harris-newsteder/PL1/documentation/PL1-0_schematic.pdf

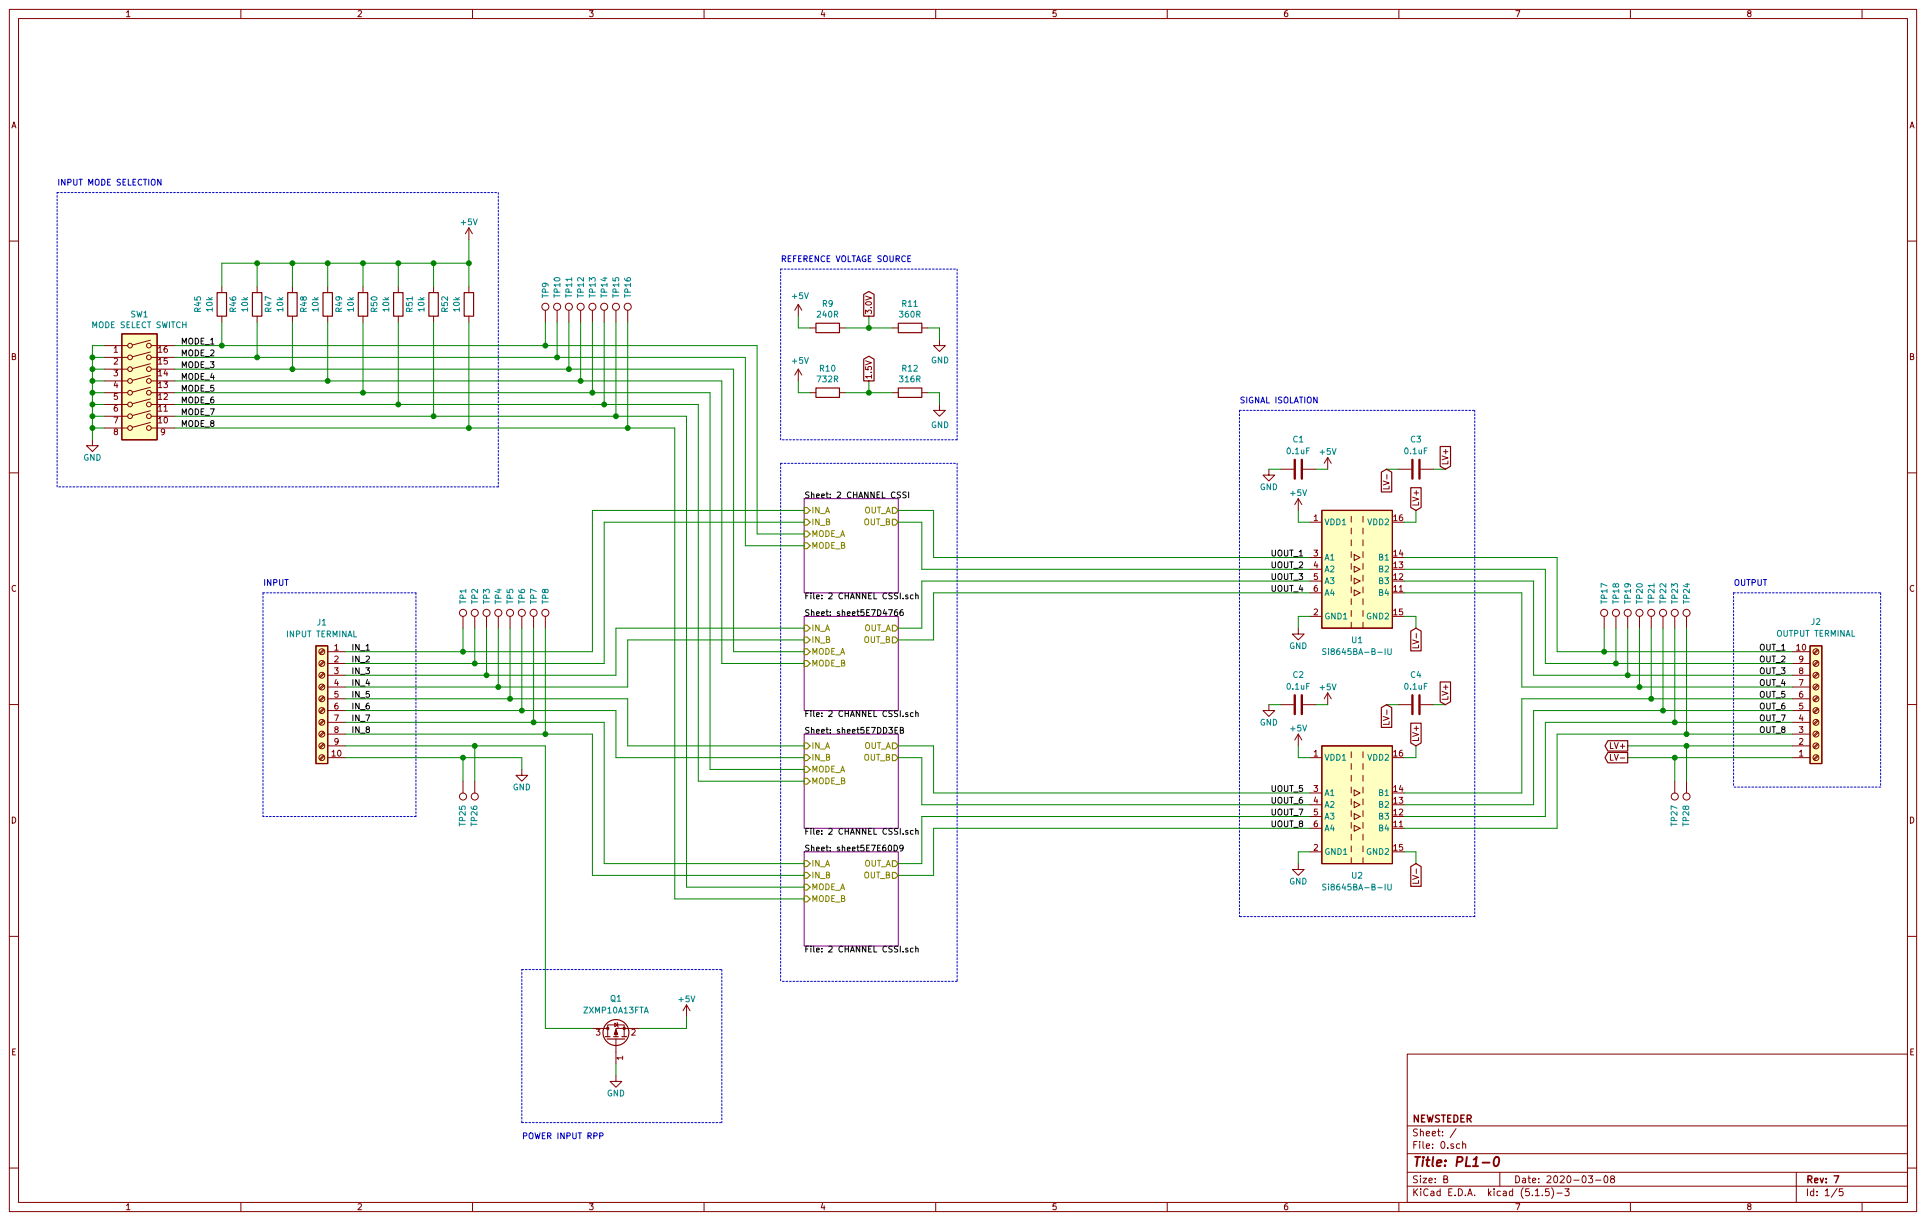
[picture p1: page 1]

Sheet: 2 CHANNEL CSSI File: 2 CHANNEL CSSI.sch

Sheet: sheet5E7D4766 File: 2 CHANNEL CSSI.sch

File: 2 CHANNEL CSSI.sch
Sheet: sheet5E7E60D9 File: 2 CHANNEL CSSI.sch

File: 0.sch Sheet: / NEWSTEDER

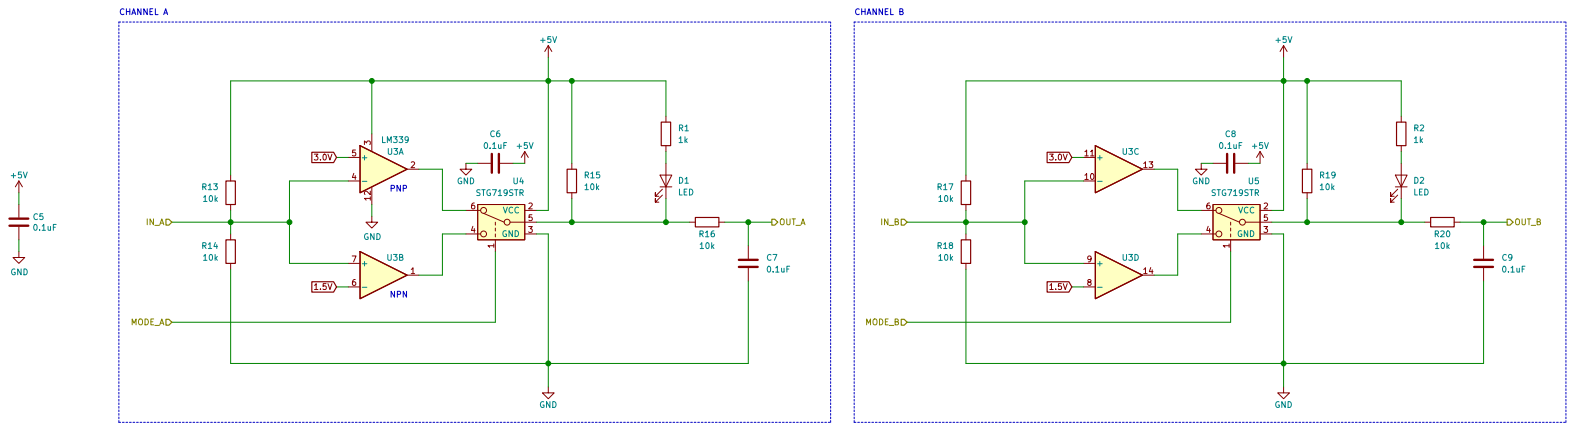
[picture p2: page 2]

File: 2 CHANNEL CSSI.sch Sheet: /2 CHANNEL CSSI/ NEWSTEDER

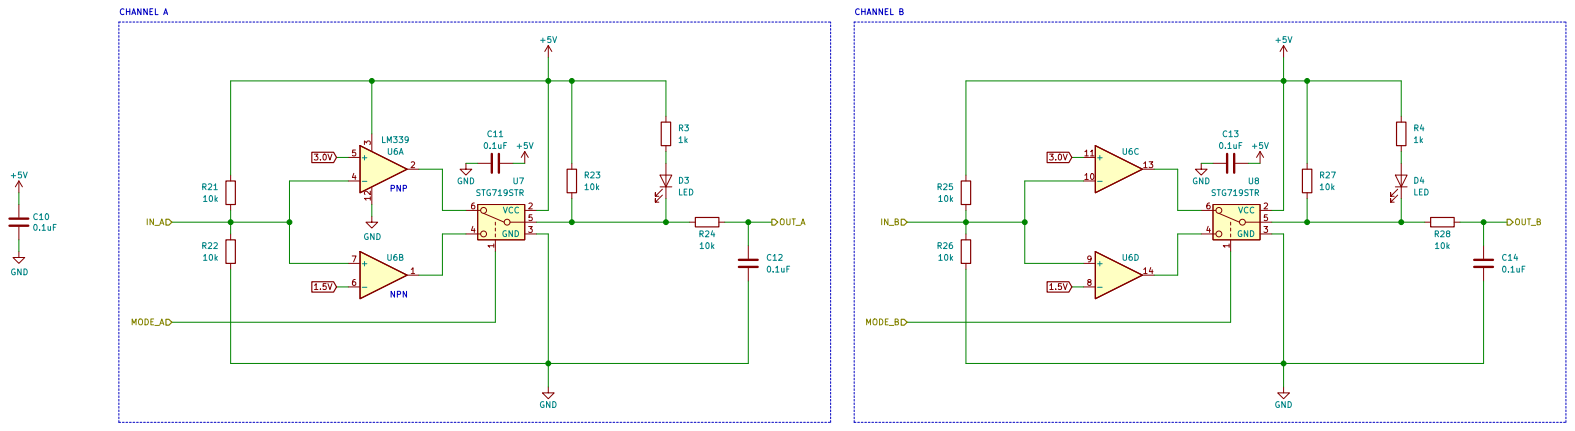
[picture p3: page 3]

File: 2 CHANNEL CSSI.sch Sheet: /sheet5E7D4766/ NEWSTEDER

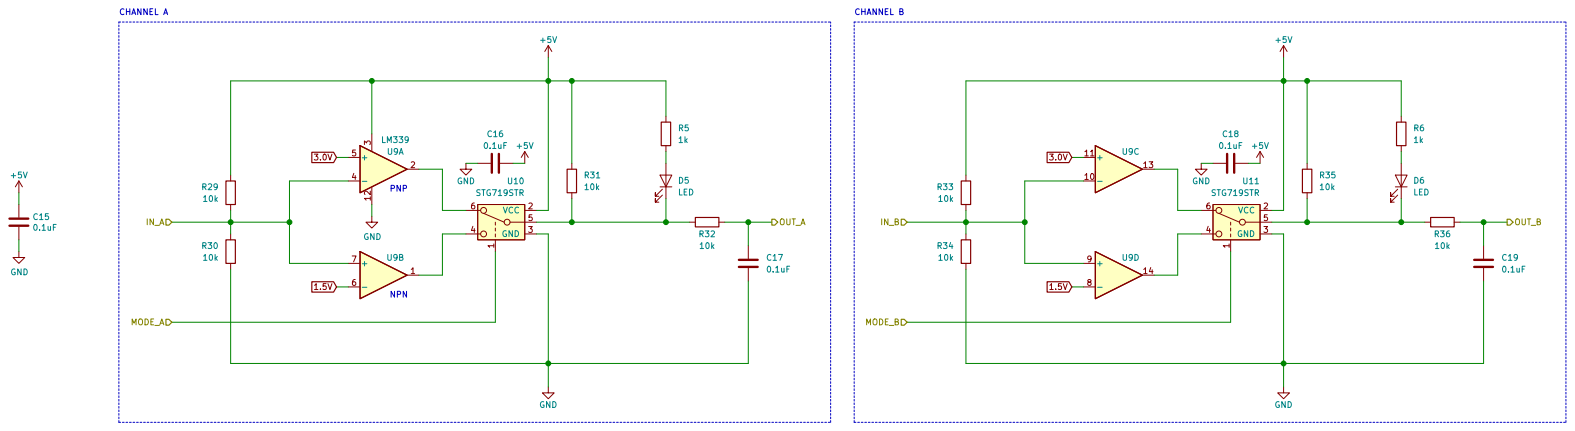
[picture p4: page 4]

File: 2 CHANNEL CSSI.sch Sheet: /sheet5E7DD3EB/ NEWSTEDER

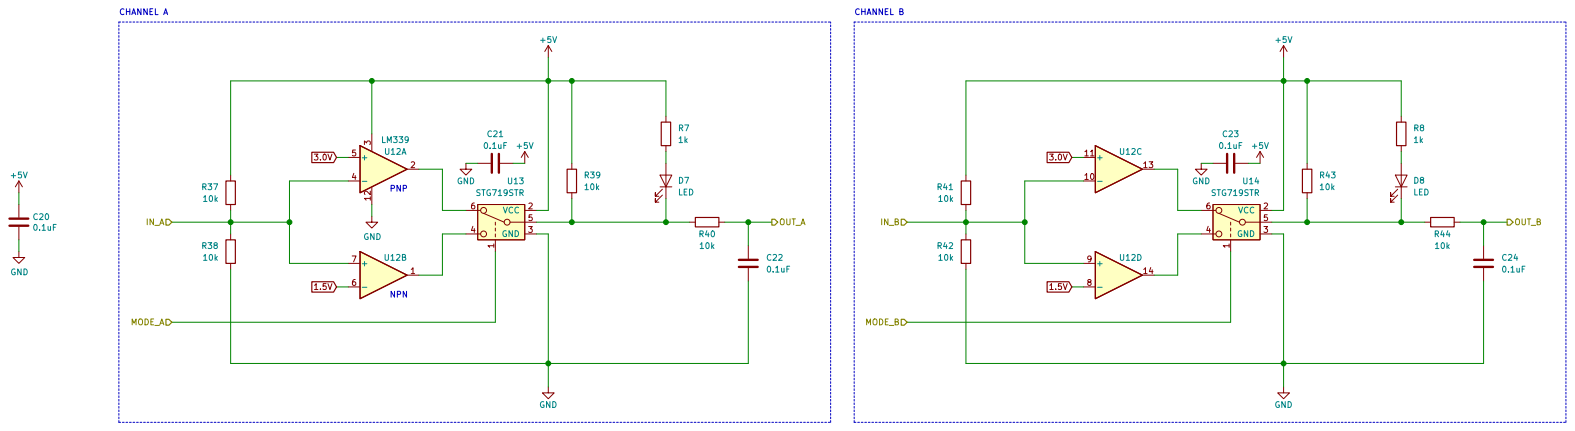
[picture p5: page 5]

File: 2 CHANNEL CSSI.sch Sheet: /sheet5E7E60D9/ NEWSTEDER
