harris-newsteder/PL1/documentation/PL1-0_dimensions.pdf

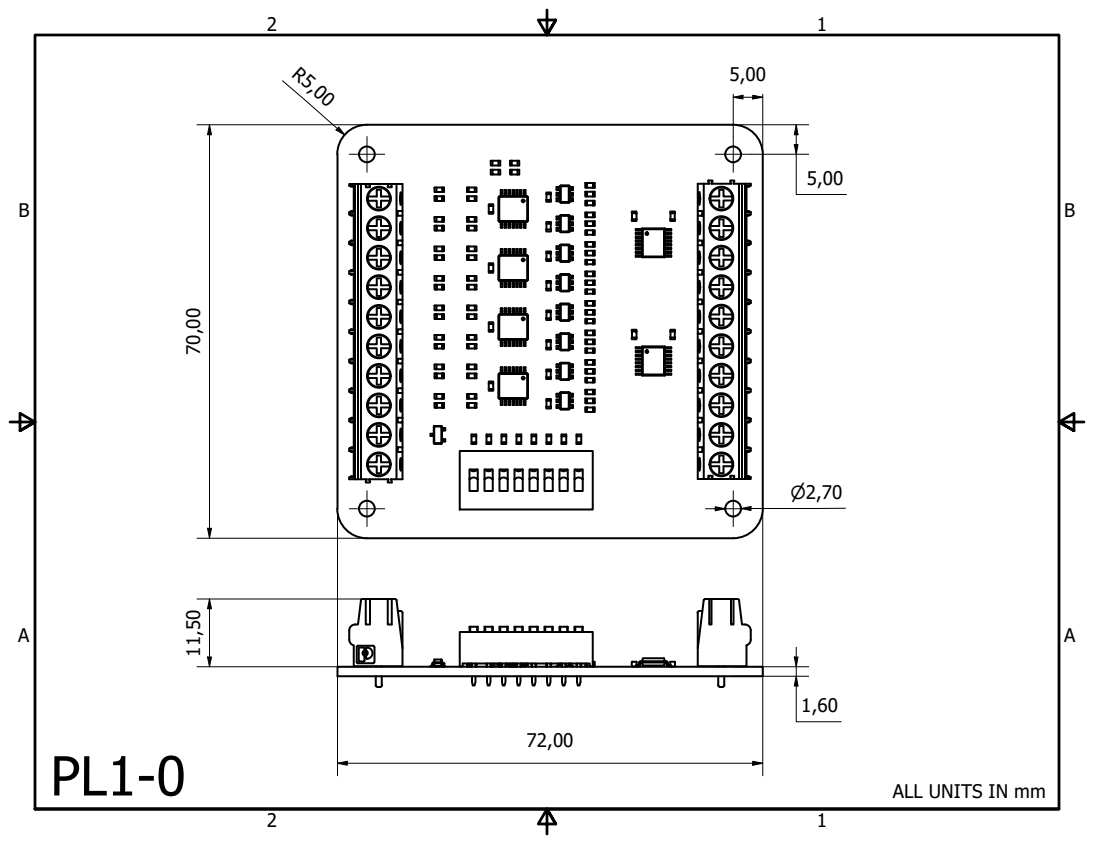
[picture p6: page 1]

ALL UNITS IN mm
