harris-newsteder/PL1/pcb/0/0.kicad_pcb

## KiCad design pcb/0/0.kicad_pcb (2020-06-17)

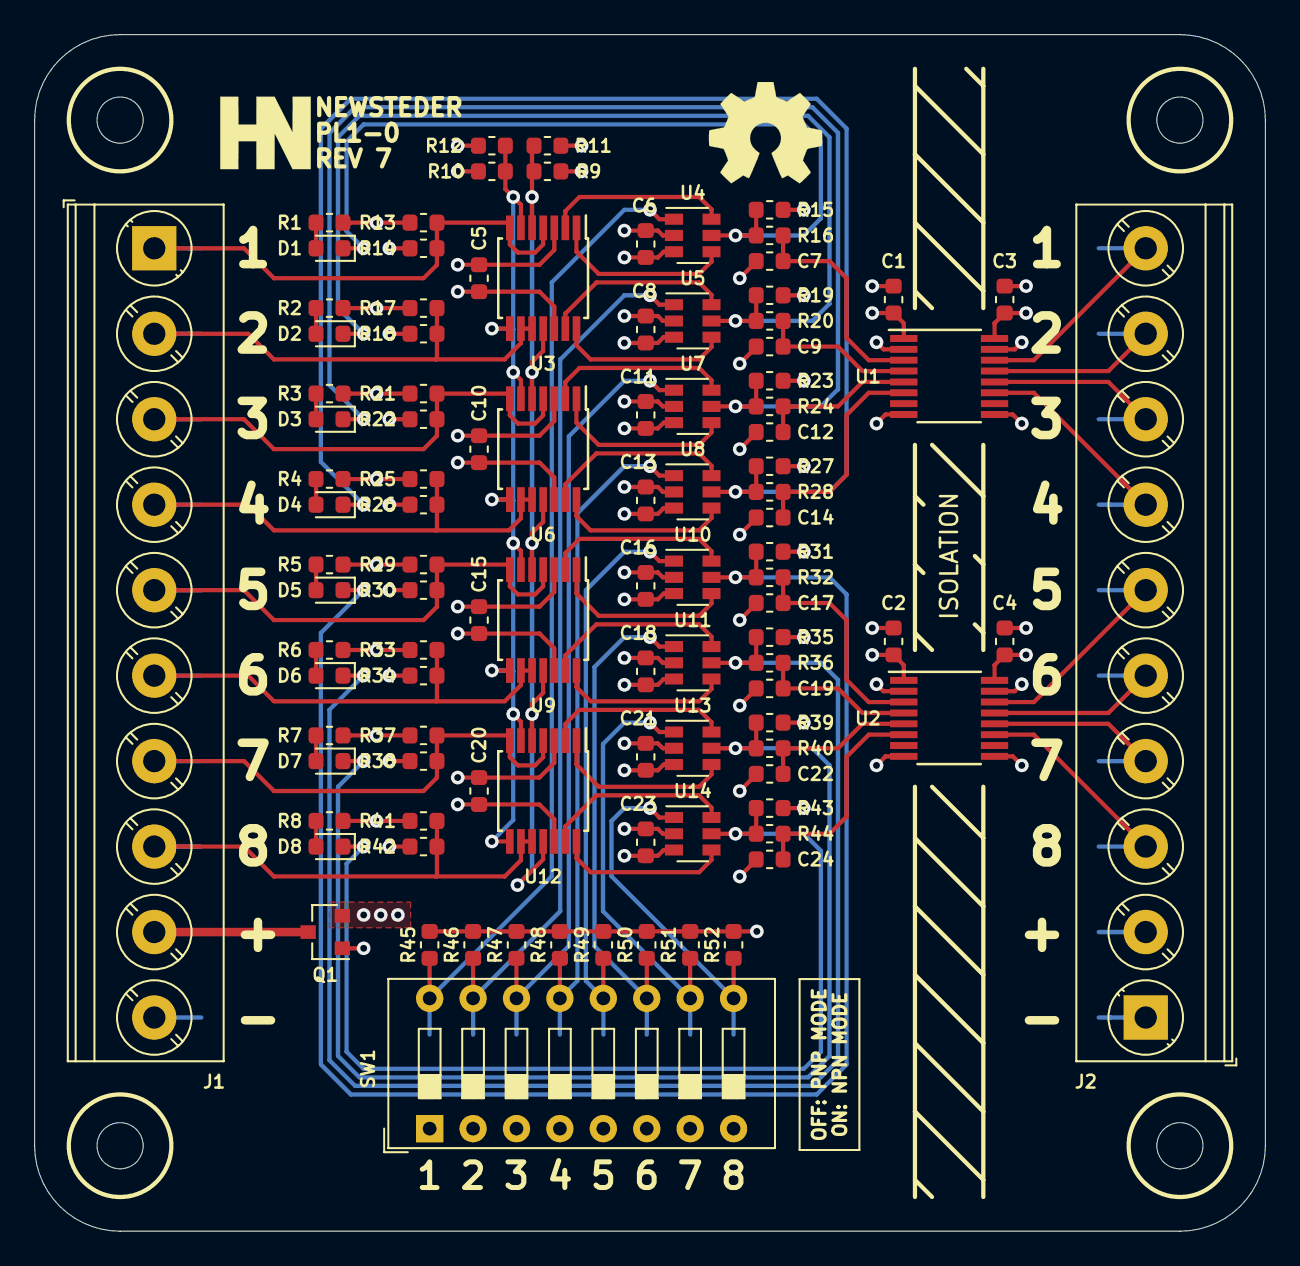
[picture p7: board 0.kicad_pcb from above]

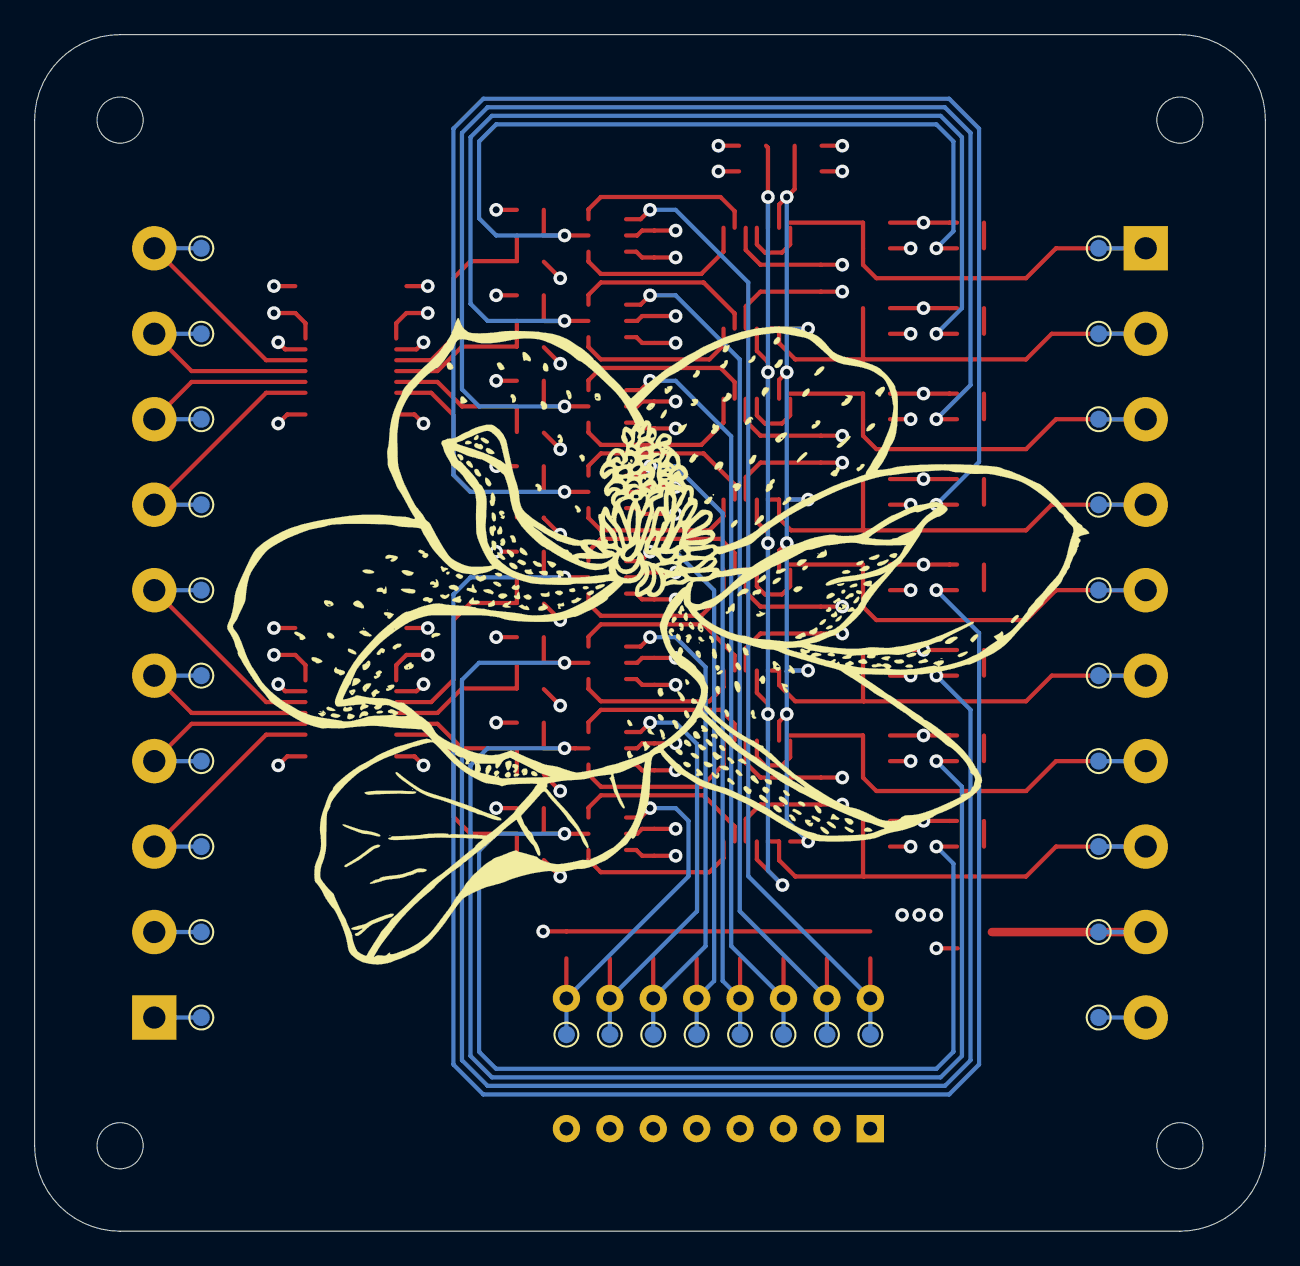
[picture p8: board 0.kicad_pcb from below]

Board: 4 copper layers, 72.0 x 70.0 mm, 130 parts (28 on the bottom side), 71 nets.

Parts:
C1, C2, C3, C4, C5, C6, C7, C8, C9, C10, C11, C12, C13, C14, C15, C16, C17, C18, C19, C20, C21, C22, C23, C24: 0.1uF; C_0603_1608Metric
D1, D2, D3, D4, D5, D6, D7, D8: LED; LED_0603_1608Metric
J1: INPUT TERMINAL; TerminalBlock_Phoenix_PT-1,5-10-5.0-H_1x10_P5.00mm_Horizont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
J2: OUTPUT TERMINAL; TerminalBlock_Phoenix_PT-1,5-10-5.0-H_1x10_P5.00mm_Horizont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
Q1: ZXMP10A13FTA; SOT-23
R1, R2, R3, R4, R5, R6, R7, R8: 1k; R_0603_1608Metric
R9: 240R; R_0603_1608Metric
R10: 732R; R_0603_1608Metric
R11: 360R; R_0603_1608Metric
R12: 316R; R_0603_1608Metric
R13, R14, R15, R16, R17, R18, R19, R20, R21, R22, R23, R24, R25, R26, R27, R28, R29, R30, R31, R32, R33, R34, R35, R36, R37, R38, R39, R40, R41, R42, R43, R44, R45, R46, R47, R48, R49, R50, R51, R52: 10k; R_0603_1608Metric
SW1: MODE SELECT SWITCH; SW_DIP_SPSTx08_Slide_9.78x22.5mm_W7.62mm_P2.54mm
TP1, TP2, TP3, TP4, TP5, TP6, TP7, TP8, TP9, TP10, TP11, TP12, TP13, TP14, TP15, TP16, TP17, TP18, TP19, TP20, TP21, TP22, TP23, TP24, TP25, TP26, TP27, TP28: TestPoint; TestPoint_Pad_D1.0mm
U1, U2: Si8645BA-B-IU; QSOP-16_3.9x4.9mm_P0.635mm
U3, U6, U9, U12: LM339; TSSOP-14_4.4x5mm_P0.65mm
U4, U5, U7, U8, U10, U11, U13, U14: STG719STR; SOT-23-6

Connections:
1.5V: R10.2, R12.1, U3.6, U3.8, U6.6, U6.8, U9.6, U9.8, U12.6, U12.8
3.0V: R9.2, R11.1, U3.5, U3.11, U6.5, U6.11, U9.5, U9.11, U12.5, U12.11
+5V: C1.2, C2.2, C5.1, C6.1, C8.1, C10.1, C11.1, C13.1, C15.1, C16.1, C18.1, C20.1, C21.1, C23.1, Q1.2, R1.1, R2.1, R3.1, R4.1, R5.1, R6.1, R7.1, R8.1, R9.1, R10.1, R13.1, R15.1, R17.1, R19.1, R21.1, R23.1, R25.1, R27.1, R29.1, R31.1, R33.1, R35.1, R37.1, R39.1, R41.1, R43.1, R45.1, R46.1, R47.1, R48.1, R49.1, R50.1, R51.1, R52.1, U1.1, U2.1, U3.3, U4.2, U5.2, U6.3, U7.2, U8.2, U9.3, U10.2, U11.2, U12.3, U13.2, U14.2
/IN_1: J1.1, R13.2, R14.1, TP1.1, U3.4, U3.7
/IN_2: J1.2, R17.2, R18.1, TP2.1, U3.9, U3.10
/IN_3: J1.3, R21.2, R22.1, TP3.1, U6.4, U6.7
/IN_4: J1.4, R25.2, R26.1, TP4.1, U6.9, U6.10
/IN_5: J1.5, R29.2, R30.1, TP5.1, U9.4, U9.7
/IN_6: J1.6, R33.2, R34.1, TP6.1, U9.9, U9.10
/IN_7: J1.7, R37.2, R38.1, TP7.1, U12.4, U12.7
/IN_8: J1.8, R41.2, R42.1, TP8.1, U12.9, U12.10
/MODE_1: R45.2, SW1.16, TP9.1, U4.1
/MODE_2: R46.2, SW1.15, TP10.1, U5.1
/MODE_3: R47.2, SW1.14, TP11.1, U7.1
/MODE_4: R48.2, SW1.13, TP12.1, U8.1
/MODE_5: R49.2, SW1.12, TP13.1, U10.1
/MODE_6: R50.2, SW1.11, TP14.1, U11.1
/MODE_7: R51.2, SW1.10, TP15.1, U13.1
/MODE_8: R52.2, SW1.9, TP16.1, U14.1
/OUT_1: J2.10, TP17.1, U1.14
/OUT_2: J2.9, TP18.1, U1.13
/OUT_3: J2.8, TP19.1, U1.12
/OUT_4: J2.7, TP20.1, U1.11
/OUT_5: J2.6, TP21.1, U2.14
/OUT_6: J2.5, TP22.1, U2.13
/OUT_7: J2.4, TP23.1, U2.12
/OUT_8: J2.3, TP24.1, U2.11
/UOUT_1: C7.1, R16.1, U1.3
/UOUT_2: C9.1, R20.1, U1.4
/UOUT_3: C12.1, R24.1, U1.5
/UOUT_4: C14.1, R28.1, U1.6
/UOUT_5: C17.1, R32.1, U2.3
/UOUT_6: C19.1, R36.1, U2.4
/UOUT_7: C22.1, R40.1, U2.5
/UOUT_8: C24.1, R44.1, U2.6
GND: C1.1, C2.1, C5.2, C6.2, C7.2, C8.2, C9.2, C10.2, C11.2, C12.2, C13.2, C14.2, C15.2, C16.2, C17.2, C18.2, C19.2, C20.2, C21.2, C22.2, C23.2, C24.2, J1.10, Q1.1, R11.2, R12.2, R14.2, R18.2, R22.2, R26.2, R30.2, R34.2, R38.2, R42.2, SW1.1, SW1.2, SW1.3, SW1.4, SW1.5, SW1.6, SW1.7, SW1.8, TP25.1, U1.2, U1.8, U2.2, U2.8, U3.12, U4.3, U5.3, U6.12, U7.3, U8.3, U9.12, U10.3, U11.3, U12.12, U13.3, U14.3
LV+: C3.2, C4.2, J2.2, TP28.1, U1.16, U2.16
LV-: C3.1, C4.1, J2.1, TP27.1, U1.9, U1.15, U2.9, U2.15
unnamed: D1.1, R15.2, R16.2, U4.5
unnamed: D1.2, R1.2
unnamed: D2.1, R19.2, R20.2, U5.5
unnamed: D2.2, R2.2
unnamed: D3.1, R23.2, R24.2, U7.5
unnamed: D3.2, R3.2
unnamed: D4.1, R27.2, R28.2, U8.5
unnamed: D4.2, R4.2
unnamed: D5.1, R31.2, R32.2, U10.5
unnamed: D5.2, R5.2
unnamed: D6.1, R35.2, R36.2, U11.5
unnamed: D6.2, R6.2
unnamed: D7.1, R39.2, R40.2, U13.5
unnamed: D7.2, R7.2
unnamed: D8.1, R43.2, R44.2, U14.5
unnamed: D8.2, R8.2
unnamed: J1.9, Q1.3, TP26.1
unnamed: U3.1, U4.4
unnamed: U3.2, U4.6
unnamed: U3.13, U5.6
unnamed: U3.14, U5.4
unnamed: U6.1, U7.4
unnamed: U6.2, U7.6
unnamed: U6.13, U8.6
unnamed: U6.14, U8.4
unnamed: U9.1, U10.4
unnamed: U9.2, U10.6
unnamed: U9.14, U11.4
unnamed: U9.13, U11.6
unnamed: U12.1, U13.4
unnamed: U12.2, U13.6
unnamed: U12.13, U14.6
unnamed: U12.14, U14.4
